ZeniteSolar/MSC22/README.md

# MSC22
Atalização do Módulo Sensor Can 19 https://github.com/ZeniteSolar/MSC19  Agora com alimentação bipolar +/- 15V para os sensores. Estágio analógico devidamente ajustado.
