ZeniteSolar/MSC22/hardware/Bibliotecas/rj45.step

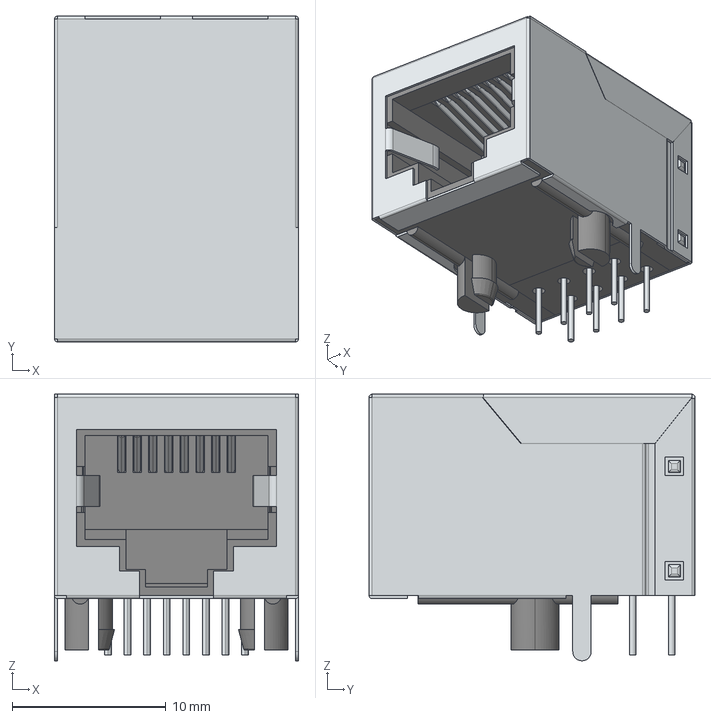
[picture p1: CAD file, 2022-03-04]
hardware/Bibliotecas/rj45.step
15.9 x 21.2 x 17.3 mm
