ZeniteSolar/MSC22/hardware/shapes3D/K78Lxx-1000R3.stp

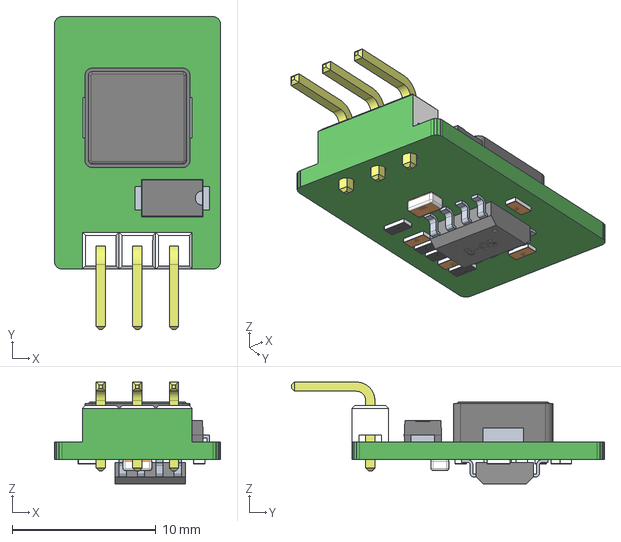
[picture p2: CAD file, 2022-06-16]
hardware/shapes3D/K78Lxx-1000R3.stp
11.5 x 21.7 x 7.08 mm
