ZeniteSolar/MSC22/simulations/INA826_2.asc

C1: cap; 1µ
C8: cap; 1n
C9: cap; 1n
C10: cap; 10µ
C11: cap; 100n
C12: cap; 100n
C13: cap; 1µ
Panel: voltage-; SINE(20 20 10k)
R10: res; 22k
R11: res; 22k
R13: res; 10
R15: res; 8.2k
R16: res; 8.2k
Rloadb1: res; 10k
U3: INA826
U4: 7805
V1: voltage-; 18
V2: voltage-; PULSE(5 17 0 30m 1m 1m 32m)
V3: voltage-; 18
V4: voltage; 15
V5: voltage; 15
Named nets: Vp+, Vp-, +5V, 0, Vpsen, INA826_IN-, INA826_IN+, Vin
.tran 0 32m 50u startup
