ZeniteSolar/MSC22/simulations/INA826.asc

C1: cap; 1n
C2: cap; 1n
R1: res; 100k
R3: res; 1k
R4: res; 12k
R5: res; 1k
R6: res; 18k
R7: res; 18k
U1: INA826
V1: voltage-; 15
V2: voltage; PULSE(8 17 0 60m 1m 3m 64m)
V3: voltage; 12
V4: voltage; 12
V6: voltage-; -5
Named nets: Vcc, 0, Vbat3, IN+, IN-, Vout, Vbat1, Vbat2, GND1, Vcc-
.tran 0.3
