ZeniteSolar/MSC22/firmware/stm32cubemx/Core/Inc/main.h

#define LED0_Pin GPIO_PIN_12
#define LED0_GPIO_Port GPIOB
#define LED1_Pin GPIO_PIN_13
#define LED1_GPIO_Port GPIOB
#define JUMP0_Pin GPIO_PIN_14
#define JUMP0_GPIO_Port GPIOB
