ZeniteSolar/MSC22/(commit log)

2022-03-04 Add files via upload
    Projeto da PCB no kicad
    [Alimentação LEM LA 150-P.kicad_pcb, Alimentação LEM LA 150-P.sch, Bipolar15V.sch, analog.sch, analog_bipolar.sch, atmega328p.sch, canbus.sch, canbus_connector.sch]
2022-05-14 Mudança do conversor 18V -> +/- 15V
    [Alimentação LEM LA 150-P.kicad_pcb, Alimentação LEM LA 150-P.kicad_sch, Bipolar15V.kicad_sch, analog_bipolar.kicad_sch, atmega328p.kicad_sch, canbus.kicad_sch, canbus_connector.kicad_sch, supplies.kicad_sch]
2022-05-14 Troca do atmega328p -> STM32F103C8T Já que tem CAN integrado e ADC 12 bits (ao invés de 10)
    [Alimentação LEM LA 150-P.kicad_pcb, Alimentação LEM LA 150-P.kicad_sch, STM32.kicad_sch, analog_bipolar.kicad_sch, canbus.kicad_sch, canbus_connector.kicad_sch, supplies.kicad_sch]
2022-05-16 Primeiro protótipo da PCB
    [Alimentação LEM LA 150-P.kicad_pcb, Alimentação LEM LA 150-P.kicad_sch, STM32.kicad_sch, analog_bipolar.kicad_sch, canbus.kicad_sch, supplies.kicad_sch]
2022-05-17 firmware: Added stm32cubemx initial project - only pins and clock are configured.
2022-05-17 hardware: STM32, PCB design in progress
    [currentsensormodule.kicad_pcb, currentsensormodule.kicad_sch, currentsensormodule.sch, stm32.sch]
2022-05-25 Melhoria na PCB
    [currentsensormodule.kicad_pcb]
2022-05-25 PCB update: silkscreen drawn
    [currentsensormodule.kicad_pcb]
2022-05-30 STLink 3v3 protection diode, silkscreen updates
    [analog_bipolar.kicad_sch, currentsensormodule.kicad_pcb, currentsensormodule.kicad_sch, supplies.kicad_sch]
2022-06-04 Silkscreen finished, module components '.csv'
    [analog_bipolar.kicad_sch, currentsensormodule.csv, currentsensormodule.kicad_pcb]
2022-06-08 hardware: analog stage adjusted for application
    [analog_bipolar.kicad_sch, currentsensormodule.kicad_pcb, currentsensormodule.kicad_sch]
2022-06-12 hardware: PCB size adjust
    [currentsensormodule.kicad_pcb]
2022-06-16 hardware: fixed RJ45 footp sh pin, added shapes3D (including K78L15)
    [K78Lxx-1000R3.stp, analog_bipolar.kicad_sch, canbus_connector.kicad_sch, currentsensormodule.kicad_pcb, currentsensormodule.kicad_sch]
2022-06-21 Pequenas mudanças na silkscreen
    [currentsensormodule.kicad_pcb, currentsensormodule.kicad_sch]
2022-06-27 hardware: Design constraints adjusted according to JLC pcb limits
    [currentsensormodule.kicad_pcb]
2022-06-29 hardware: Silkscreen ajusted, RDC errors fixed
    [currentsensormodule.kicad_pcb, currentsensormodule.kicad_sch]
2022-06-29 hardware: silkscreen updated
    [currentsensormodule.kicad_pcb]
2022-06-30 Silkscreen JLC update. Finished.
    [currentsensormodule.kicad_pcb]
2023-04-04 add BOM
